peter-noerlund/sky25a-levenshtein/README.md

   

# Fuzzy Search Engine

A fuzzy search engine "accelerator"

- [Read the documentation for project](docs/info.md)
