peter-noerlund/sky25a-levenshtein/src/levenshtein_controller.sv

`default_nettype none

module levenshtein_controller
    #(
        parameter int unsigned MASTER_ADDR_WIDTH=24,
        parameter int unsigned SLAVE_ADDR_WIDTH=24,
        parameter int unsigned BITVECTOR_WIDTH=16,
        parameter int unsigned BURST_SIZE=4
    )
    (
        input wire clk_i,
        input wire rst_i,

        //! @virtualbus WBM @dir out Wishbone master
        output wire wbm_cyc_o,
        output wire wbm_stb_o,
        output logic [MASTER_ADDR_WIDTH - 1 : 0] wbm_adr_o,
        output wire wbm_we_o,
        output wire [7:0] wbm_dat_o,
        output logic [2:0] wbm_cti_o,
        output logic [1:0] wbm_bte_o,
        input wire wbm_ack_i,
        input wire wbm_err_i,
        input wire wbm_rty_i,
        input wire [7:0] wbm_dat_i,
        //! @end

        //! @virtualbus WBS @dir in Wishbone slave
        input wire wbs_cyc_i,
        input wire wbs_stb_i,
        /* verilator lint_off UNUSEDSIGNAL */
        input wire [SLAVE_ADDR_WIDTH - 1 : 0] wbs_adr_i,
        /* verilator lint_on UNUSEDSIGNAL */
        input wire wbs_we_i,
        /* verilator lint_off UNUSEDSIGNAL */
        input wire [7:0] wbs_dat_i,
        input wire [2:0] wbs_cti_i,
        input wire [1:0] wbs_bte_i,
        /* verilator lint_on UNUSEDSIGNAL */
        output logic wbs_ack_o,
        output wire wbs_err_o,
        output wire wbs_rty_o,
        output logic [7:0] wbs_dat_o,
        //! @end

        output logic [1:0] sram_config
    );

    localparam CTI_CLASSIC = 3'b000;
    localparam CTI_INCREMENTAL_BURST = 3'b010;
    localparam CTI_END_OF_BURST = 3'b111;

    localparam BTE_LINEAR_BURST = 2'b00;

    localparam BITVECTOR_BYTES = (BITVECTOR_WIDTH + 7) / 8;
    localparam BITVECTOR_ADDR_SUFFIX_WIDTH = $clog2(BITVECTOR_BYTES);
    localparam STATE_COUNT = 2 + BURST_SIZE + BITVECTOR_BYTES;
    localparam STATE_WIDTH = $clog2(STATE_COUNT + 1);

    localparam DICT_ADDR_SUFFIX_WIDTH = $clog2(BURST_SIZE);
    localparam DICT_ADDR_WIDTH = MASTER_ADDR_WIDTH - DICT_ADDR_SUFFIX_WIDTH;
    localparam SYMBOL_INDEX_WIDTH = DICT_ADDR_SUFFIX_WIDTH;

    localparam DISTANCE_WIDTH = 8;
    localparam ID_WIDTH = 16;

    localparam WORD_LENGTH_REG_WIDTH = $clog2(BITVECTOR_WIDTH);
    localparam WORD_LENGTH_WIDTH = $clog2(BITVECTOR_WIDTH + 1);

    localparam ADDR_CTRL = 3'd0;
    localparam ADDR_SRAM_CTRL = 3'd1;
    localparam ADDR_LENGTH = 3'd2;
    localparam ADDR_MAX_LENGTH = 3'd3;
    localparam ADDR_INDEX_HI = 3'd4;
    localparam ADDR_INDEX_LO = 3'd5;
    localparam ADDR_DISTANCE = 3'd6;
    
    localparam WORD_TERMINATOR = 8'h00;
    localparam DICT_TERMINATOR = 8'h01;

    localparam REAL_DICT_ADDR = MASTER_ADDR_WIDTH'({10'b10_00000000, BITVECTOR_ADDR_SUFFIX_WIDTH'(0)});
    localparam DICT_ADDR = REAL_DICT_ADDR[MASTER_ADDR_WIDTH - 1 -: DICT_ADDR_WIDTH];

    logic enabled;
    logic [WORD_LENGTH_REG_WIDTH - 1 : 0] word_length_reg;
    wire [BITVECTOR_WIDTH - 1 : 0] mask;
    wire [BITVECTOR_WIDTH - 1 : 0] initial_vp;
    wire [WORD_LENGTH_WIDTH - 1 : 0] word_length;

    localparam STATE_READ_DICT_BASE = STATE_WIDTH'(0);
    localparam STATE_PROCESS = STATE_READ_DICT_BASE + STATE_WIDTH'(BURST_SIZE);
    localparam STATE_LEVENSHTEIN = STATE_PROCESS + STATE_WIDTH'(1);
    localparam STATE_READ_VECTOR_BASE = STATE_LEVENSHTEIN + STATE_WIDTH'(1);

    logic [STATE_WIDTH - 1 : 0] state;
    logic [DICT_ADDR_WIDTH - 1 : 0] dict_address;
    logic cyc;
    logic [BITVECTOR_WIDTH - 1 : 0] pm;
    wire [BITVECTOR_WIDTH - 1 : 0] d0;
    wire [BITVECTOR_WIDTH - 1 : 0] hp;
    wire [BITVECTOR_WIDTH - 1 : 0] hn;
    wire [BITVECTOR_WIDTH - 1 : 0] next_vp;
    wire [BITVECTOR_WIDTH - 1 : 0] next_vn;
    logic [BITVECTOR_WIDTH - 1 : 0] vp;
    logic [BITVECTOR_WIDTH - 1 : 0] vn;
    logic [DISTANCE_WIDTH - 1 : 0] d;

    logic [ID_WIDTH - 1 : 0] idx;
    logic [ID_WIDTH - 1 : 0] best_idx;
    logic [DISTANCE_WIDTH - 1 : 0] best_distance;

    logic [BURST_SIZE * 8 - 1 : 0] symbols;
    logic [SYMBOL_INDEX_WIDTH - 1 : 0] symbol_idx;
    wire [7:0] next_symbol;
    wire [7:0] symbol;

    integer i;
    integer j;

    assign wbs_err_o = 1'b0;
    assign wbs_rty_o = 1'b0;
    assign wbm_cyc_o = cyc;
    assign wbm_stb_o = cyc;
    assign wbm_we_o = 1'b0;
    assign wbm_dat_o = 8'h00;
    assign word_length = WORD_LENGTH_WIDTH'(word_length_reg) + WORD_LENGTH_WIDTH'(1);

    assign d0 = (((pm & vp) + vp) ^ vp) | pm | vn;
    assign hp = vn | ~(d0 | vp);
    assign hn = d0 & vp;
    assign next_vp = (hn << 1) | ~(d0 | ((hp << 1) | BITVECTOR_WIDTH'(1)));
    assign next_vn = d0 & ((hp << 1) | BITVECTOR_WIDTH'(1));

    assign initial_vp = (1 << word_length) - 1;
    assign mask = 1 << (word_length - 1);

    assign next_symbol = symbols[7:0];
    assign symbol = symbols[BURST_SIZE * 8 - 1 -: 8];

    always_comb begin
        wbm_adr_o = MASTER_ADDR_WIDTH'(0);
        wbm_cti_o = CTI_CLASSIC;
        wbm_bte_o = 2'b00;

        for (i = 0; i != BURST_SIZE; i = i + 1) begin
            if (state == STATE_READ_DICT_BASE + STATE_WIDTH'(i)) begin
                if (BURST_SIZE == 1) begin
                    wbm_adr_o = MASTER_ADDR_WIDTH'(dict_address);
                end else begin
                    wbm_adr_o = {dict_address, DICT_ADDR_SUFFIX_WIDTH'(i)};
                end
                if (BURST_SIZE == 1) begin
                    wbm_cti_o = CTI_CLASSIC;
                    wbm_bte_o = 2'b00;
                end else if (i == BURST_SIZE - 1) begin
                    wbm_cti_o = CTI_END_OF_BURST;
                    wbm_bte_o = 2'b00;
                end else begin
                    wbm_cti_o = CTI_INCREMENTAL_BURST;
                    wbm_bte_o = BTE_LINEAR_BURST;
                end
            end
        end
        
        for (i = 0; i != BITVECTOR_BYTES; i = i + 1) begin
            if (state == STATE_READ_VECTOR_BASE + STATE_WIDTH'(i)) begin
                wbm_adr_o = MASTER_ADDR_WIDTH'({1'b1, symbol, BITVECTOR_ADDR_SUFFIX_WIDTH'(i)});
                if (BITVECTOR_BYTES == 1) begin
                    wbm_cti_o = CTI_CLASSIC;
                    wbm_bte_o = 2'b00;
                end else if (i == BITVECTOR_BYTES - 1) begin
                    wbm_cti_o = CTI_END_OF_BURST;
                    wbm_bte_o = 2'b00;
                end else begin
                    wbm_cti_o = CTI_INCREMENTAL_BURST;
                    wbm_bte_o = BTE_LINEAR_BURST;
                end
            end
        end
    end

    always_comb begin
        case (wbs_adr_i[2:0])
            ADDR_CTRL: wbs_dat_o = {7'b0000000, enabled};
            ADDR_SRAM_CTRL: wbs_dat_o = {6'b000000, sram_config};
            ADDR_LENGTH: wbs_dat_o = 8'(word_length_reg);
            ADDR_MAX_LENGTH: wbs_dat_o = 8'(BITVECTOR_WIDTH - 1);
            ADDR_INDEX_HI: wbs_dat_o = best_idx[15:8];
            ADDR_INDEX_LO: wbs_dat_o = best_idx[7:0];
            ADDR_DISTANCE: wbs_dat_o = best_distance;
            default: wbs_dat_o = 8'h00;
        endcase
    end

    always @ (posedge clk_i) begin
        if (rst_i) begin
            enabled <= 1'b0;
            wbs_ack_o <= 1'b0;

            cyc <= 1'b0;
        end else begin
            if (wbs_cyc_i && wbs_stb_i && !wbs_ack_o) begin
                if (wbs_we_i) begin
                    if (wbs_adr_i[2:0] == ADDR_CTRL) begin
                        enabled <= wbs_dat_i[0];
                        if (!enabled) begin
                            state <= STATE_READ_DICT_BASE;

                            dict_address <= DICT_ADDR;
                            d <= DISTANCE_WIDTH'(word_length);
                            vn <= BITVECTOR_WIDTH'(0);
                            vp <= initial_vp;

                            idx <= ID_WIDTH'(0);
                            best_idx <= ID_WIDTH'(0);
                            best_distance <= DISTANCE_WIDTH'(-1);
                            symbol_idx <= SYMBOL_INDEX_WIDTH'(0);
                        end
                    end else if (wbs_adr_i[2:0] == ADDR_SRAM_CTRL) begin
                        sram_config <= wbs_dat_i[1:0];
                    end else if (wbs_adr_i[2:0] == ADDR_LENGTH) begin
                        word_length_reg <= wbs_dat_i[WORD_LENGTH_REG_WIDTH - 1 : 0];
                    end
                end
                wbs_ack_o <= 1'b1;
            end else begin
                wbs_ack_o <= 1'b0;
            end
        
            if (enabled) begin
                for (j = 0; j != BURST_SIZE; j = j + 1) begin
                    if (state == STATE_READ_DICT_BASE + STATE_WIDTH'(j)) begin
                        if (j == 0 && !cyc) begin
                            cyc <= 1'b1;
                        end else if (wbm_ack_i) begin
                            symbols <= {wbm_dat_i, symbols[BURST_SIZE * 8 - 1 : 8]};
                            if (j == BURST_SIZE - 1) begin
                                cyc <= 1'b0;
                                dict_address <= dict_address + DICT_ADDR_WIDTH'(1);
                                state <= STATE_PROCESS;
                            end else begin
                                state <= STATE_READ_DICT_BASE + STATE_WIDTH'(j + 1);
                            end
                        end else if (wbm_err_i || wbm_rty_i) begin
                            cyc <= 1'b0;
                            enabled <= 1'b0;
                        end
                    end
                end

                if (state == STATE_PROCESS) begin
                    symbol_idx <= symbol_idx + SYMBOL_INDEX_WIDTH'(1);
                    symbols <= {symbols[7:0], symbols[BURST_SIZE * 8 - 1 : 8]};
                    if (next_symbol == WORD_TERMINATOR) begin
                        if (d < best_distance) begin
                            best_idx <= idx;
                            best_distance <= d;
                        end
                        idx <= idx + ID_WIDTH'(1);
                        d <= DISTANCE_WIDTH'(word_length);
                        vn <= BITVECTOR_WIDTH'(0);
                        vp <= initial_vp;
                        if (symbol_idx == SYMBOL_INDEX_WIDTH'(BURST_SIZE - 1)) begin
                            state <= STATE_READ_DICT_BASE;
                        end
                    end else if (next_symbol == DICT_TERMINATOR) begin
                        enabled <= 1'b0;
                    end else begin
                        state <= STATE_READ_VECTOR_BASE;
                    end
                end

                for (j = 0; j != BITVECTOR_BYTES; j = j + 1) begin
                    if (state == STATE_READ_VECTOR_BASE + STATE_WIDTH'(j)) begin
                        if (j == 0 && !cyc) begin
                            cyc <= 1'b1;
                        end else if (wbm_ack_i) begin
                            if (j == 0 && BITVECTOR_BYTES * 8 > BITVECTOR_WIDTH) begin
                                pm[BITVECTOR_WIDTH - 1 : (BITVECTOR_BYTES - 1) * 8] <= wbm_dat_i[BITVECTOR_WIDTH - (BITVECTOR_BYTES - 1) * 8 - 1 : 0];
                            end else begin
                                pm[(BITVECTOR_BYTES - j) * 8 - 1 -: 8] <= wbm_dat_i;
                            end
                            if (j == BITVECTOR_BYTES - 1) begin
                                cyc <= 1'b0;
                                state <= STATE_LEVENSHTEIN;
                            end else begin
                                state <= STATE_READ_VECTOR_BASE + STATE_WIDTH'(j) + STATE_WIDTH'(1);
                            end
                        end else if (wbm_err_i || wbm_rty_i) begin
                            cyc <= 1'b0;
                            enabled <= 1'b0;
                        end
                    end
                end

                if (state == STATE_LEVENSHTEIN) begin
                    if ((hp & mask) != BITVECTOR_WIDTH'(0)) begin
                        d <= d + DISTANCE_WIDTH'(1);
                    end else if ((hn & mask) != BITVECTOR_WIDTH'(0)) begin
                        d <= d - DISTANCE_WIDTH'(1);
                    end
                    vp <= next_vp;
                    vn <= next_vn;
                    if (symbol_idx == SYMBOL_INDEX_WIDTH'(0)) begin
                        state <= STATE_READ_DICT_BASE;
                    end else begin
                        state <= STATE_PROCESS;
                    end
                end
            end
        end
    end
endmodule
