peter-noerlund/sky25a-levenshtein/(commit log)

2024-09-13 WIP on UART to Wishbone bridge
2024-09-14 Switch to CMake
2024-09-14 Better test and fixed SPI
    [test.py, wb2spi.sv]
2024-09-14 Fixed SPI timing
2024-09-14 Working SPI it seems
2024-09-15 Dual UART and SPI
2024-09-15 No real levenshtein, but framework is in place
2024-09-18 Fixed to controller and QSPI preparations
    [levenshtein_controller.sv, qspi_sram.sv, tb.v, test.py]
2024-09-18 Minor fixes (apparently 5% larger)
    [levenshtein_controller.sv]
2024-09-19 Disable SPI verbosity
2024-09-20 Nah, it was 85% all along - but apparently it is free to initialize at reset
    [levenshtein_controller.sv]
2024-09-20 Removed error register
    Which apparently required _more_ space, but then again, the nom_ss_100C_1v60 slew violation is gone
    [levenshtein_controller.sv]
2024-09-21 Renamed UART bridge
2024-09-21 An UART which actually works post synthesis
2024-09-22 Fixed gate level test
    [tb.v]
2024-09-28 Removed duplicate wire
2024-09-28 SPI is faster and uses less area
2024-09-28 SPI bus in client
2024-09-29 Functional SPI
2024-09-29 Way faster SPI
2024-09-29 Updated docs to reflect the use of SPI
2024-09-30 Removed all the UART stuff
2024-09-30 Revert "Follow proper naming"
    This reverts commit 22bce90241584dbcf6f1e10b0aec3ed6218f2a25.
    [tb.v, top.sv, top.v, tt_um_levenshtein.v]
2024-09-30 Configurable CS pin for SRAM
    Also reduced word length register to 4 bits
2024-10-02 !cyc_i || !stb_i is kinda a reset anyway
    [spi_controller.sv]
2024-10-02 QSPI wireing
2024-10-03 Removed uart bridge
2024-10-03 Removed reference to UART
2024-10-03 Revert "Trading speed for area"
    This reverts commit a2aa77d99f824c6103b983f5eaef431f9fc70204.
    [levenshtein_controller.sv, spi_wishbone_bridge.sv]
2024-10-03 Default to cs pin
2024-10-03 Print out actual word
2024-10-05 Let SPI access registers without disrupting SRAM
2024-10-05 Allow skipping clearing vector map
    [client.cpp, client.h, main.cpp, runner.cpp, runner.h]
2024-10-07 Adjusted to reflect 16-bit vector and added note about SPI mode
2024-10-08 Only reset control registres
    [levenshtein_controller.sv, spi_wishbone_bridge.sv]
2024-10-13 No difference, but allow yosys to infer SPRAM and use DSP for PICO-ICE
2025-09-13 Enforce unsigned parameters
    Setting BURST_SIZE=8 would cause verilator to work but icarus wouldn't.
    Hardening didn't succeed though, so we stay at 4
    [levenshtein_controller.sv]
